riezky-gitH/SIMPAS-BOILER/Hardware/3D_Render/pcb_3d_preview.jpg

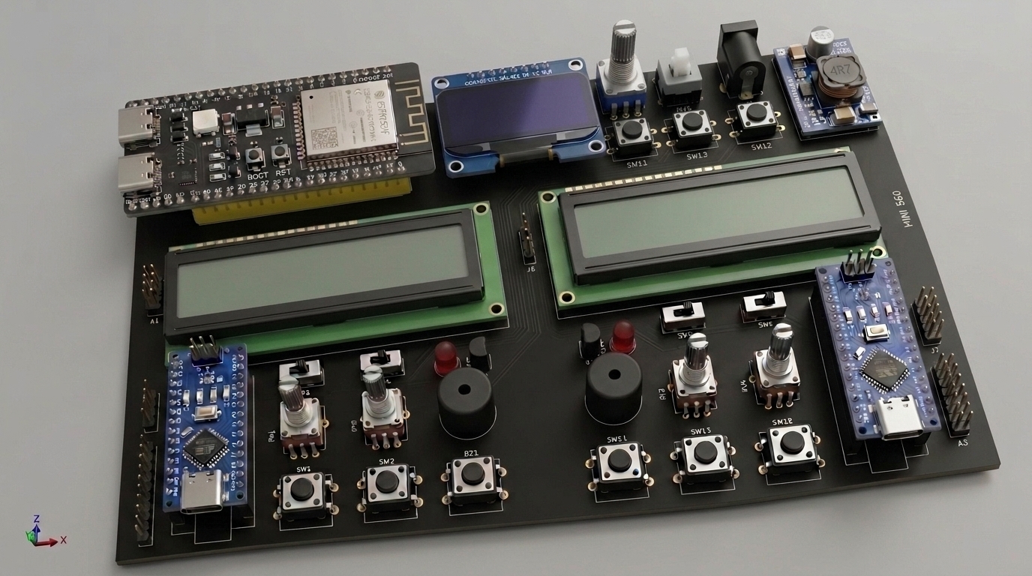
Hardware/3D_Render/pcb_3d_preview.jpg
