riezky-gitH/SIMPAS-BOILER/Hardware/Fabrication/cetak pcb wmlta zone area.pdf

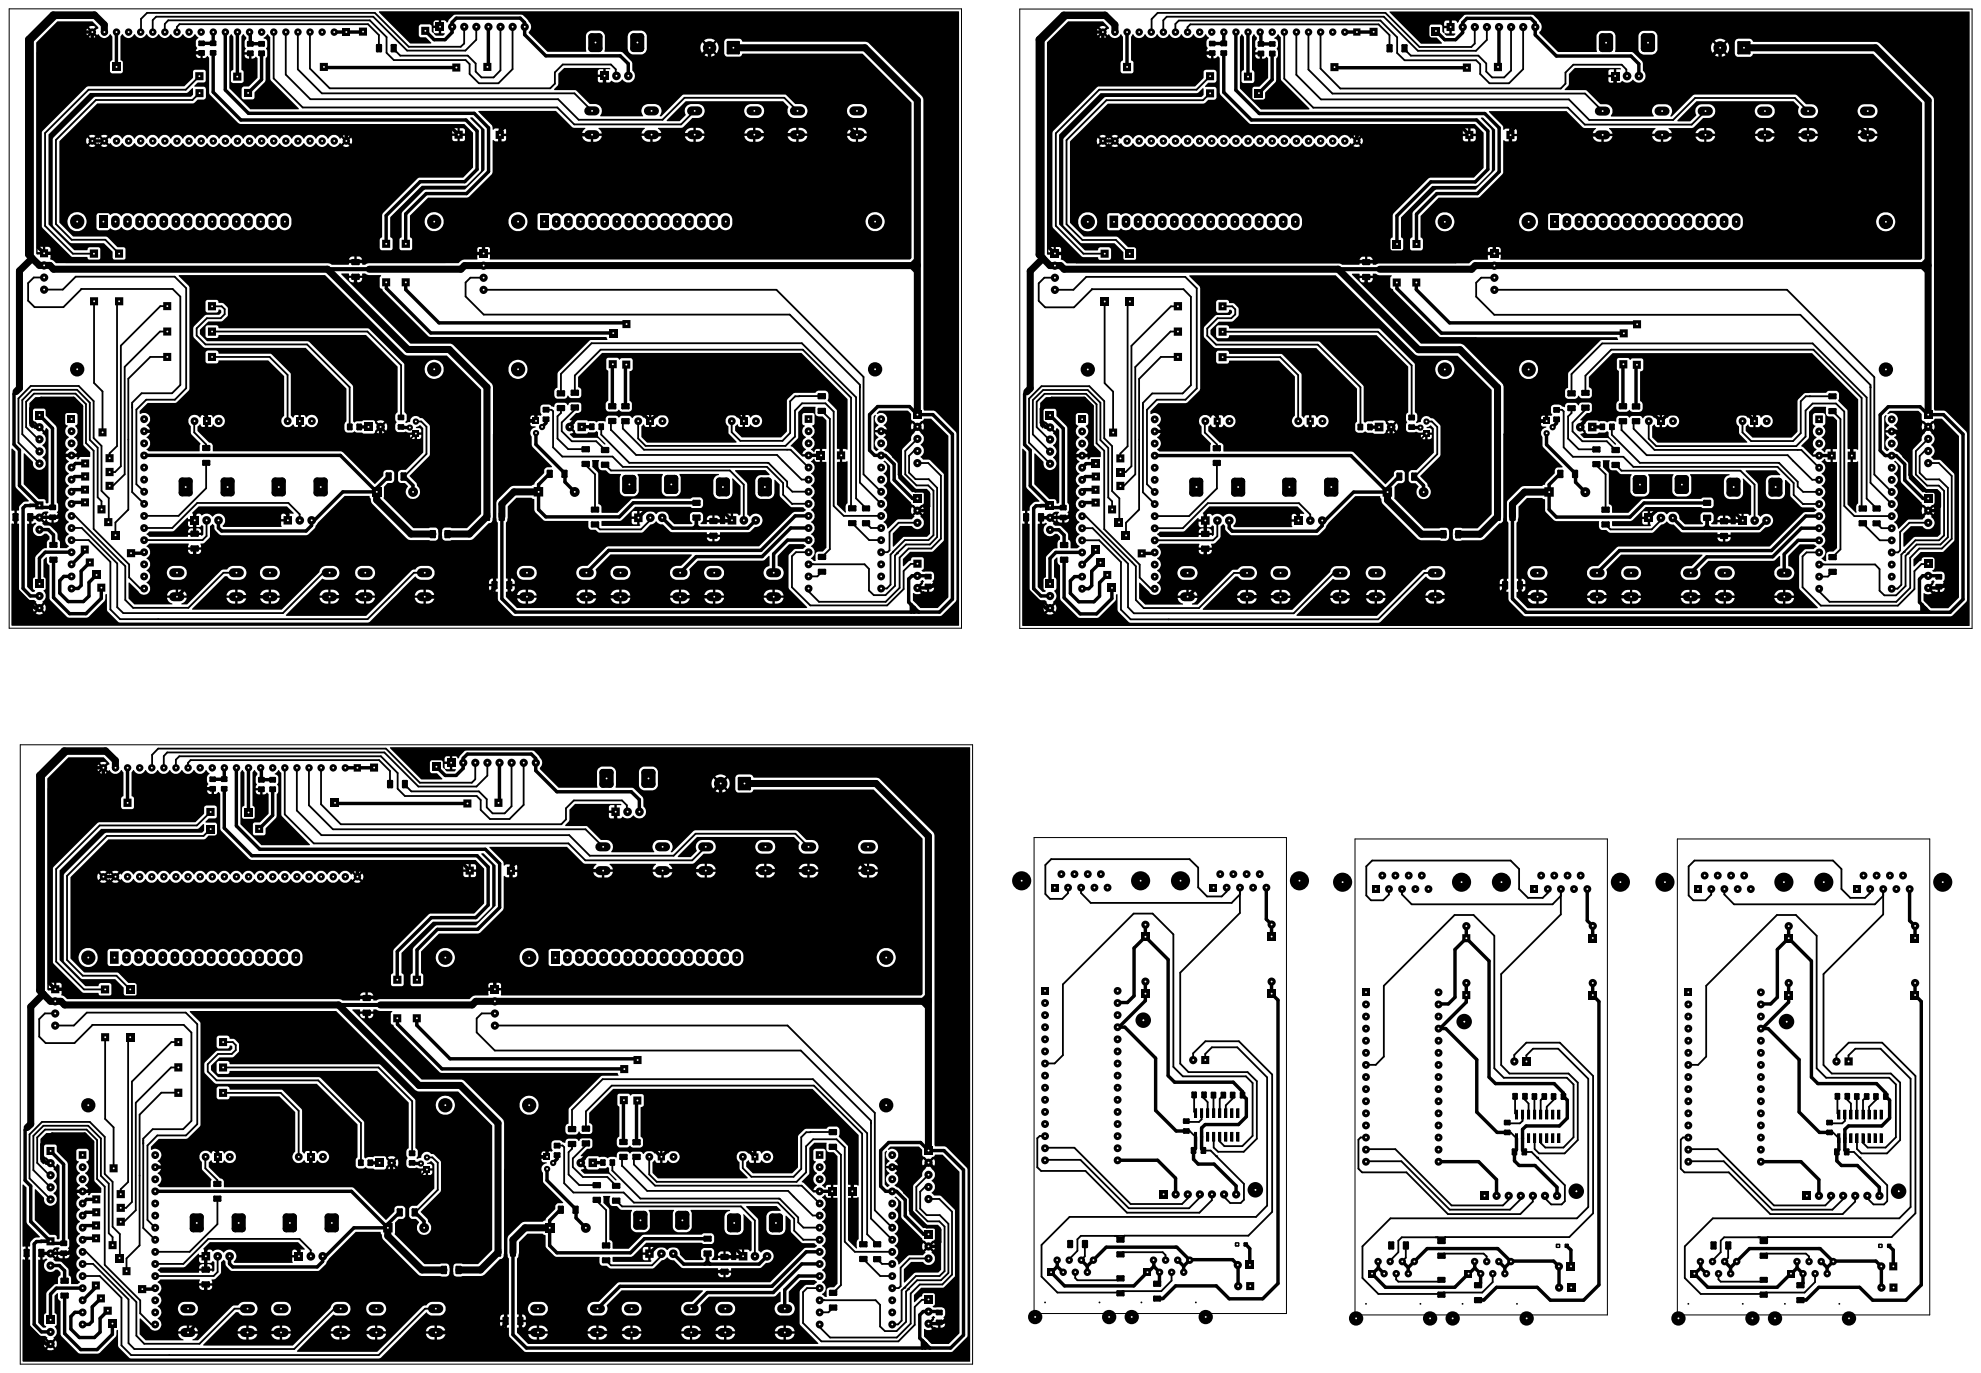
[picture p3: page 1]
