riezky-gitH/SIMPAS-BOILER/Hardware/Fabrication/esp32s3 wmlta-B_Cu.pdf

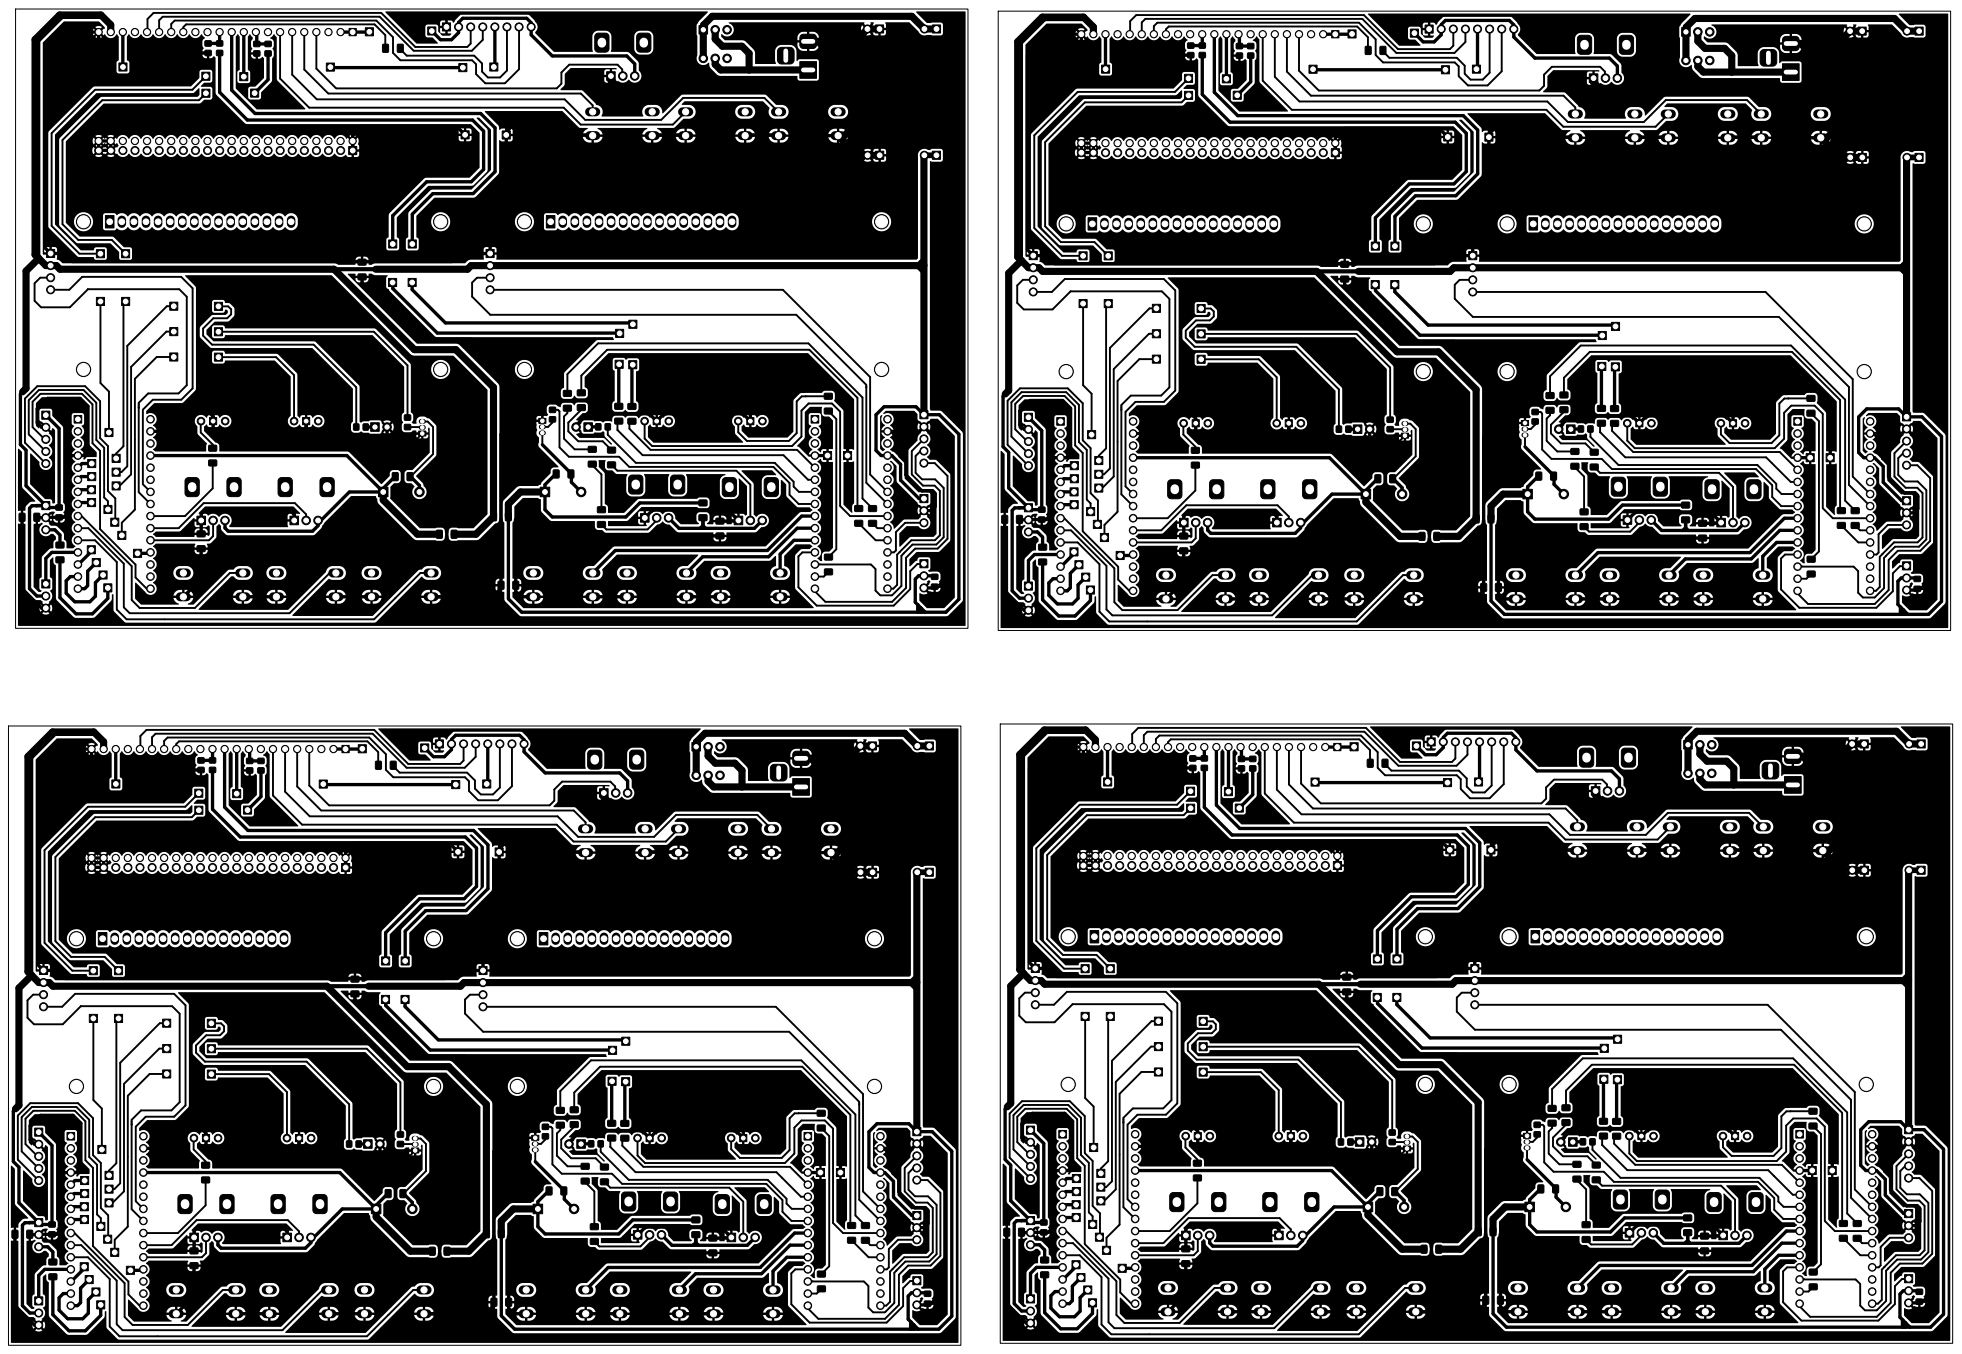
[picture p4: page 1]
