riezky-gitH/SIMPAS-BOILER/Hardware/PCB_KiCad/esp32s3 wmlta.kicad_sch

## KiCad design Hardware/PCB_KiCad/esp32s3 wmlta.kicad_sch (2026-10-23)

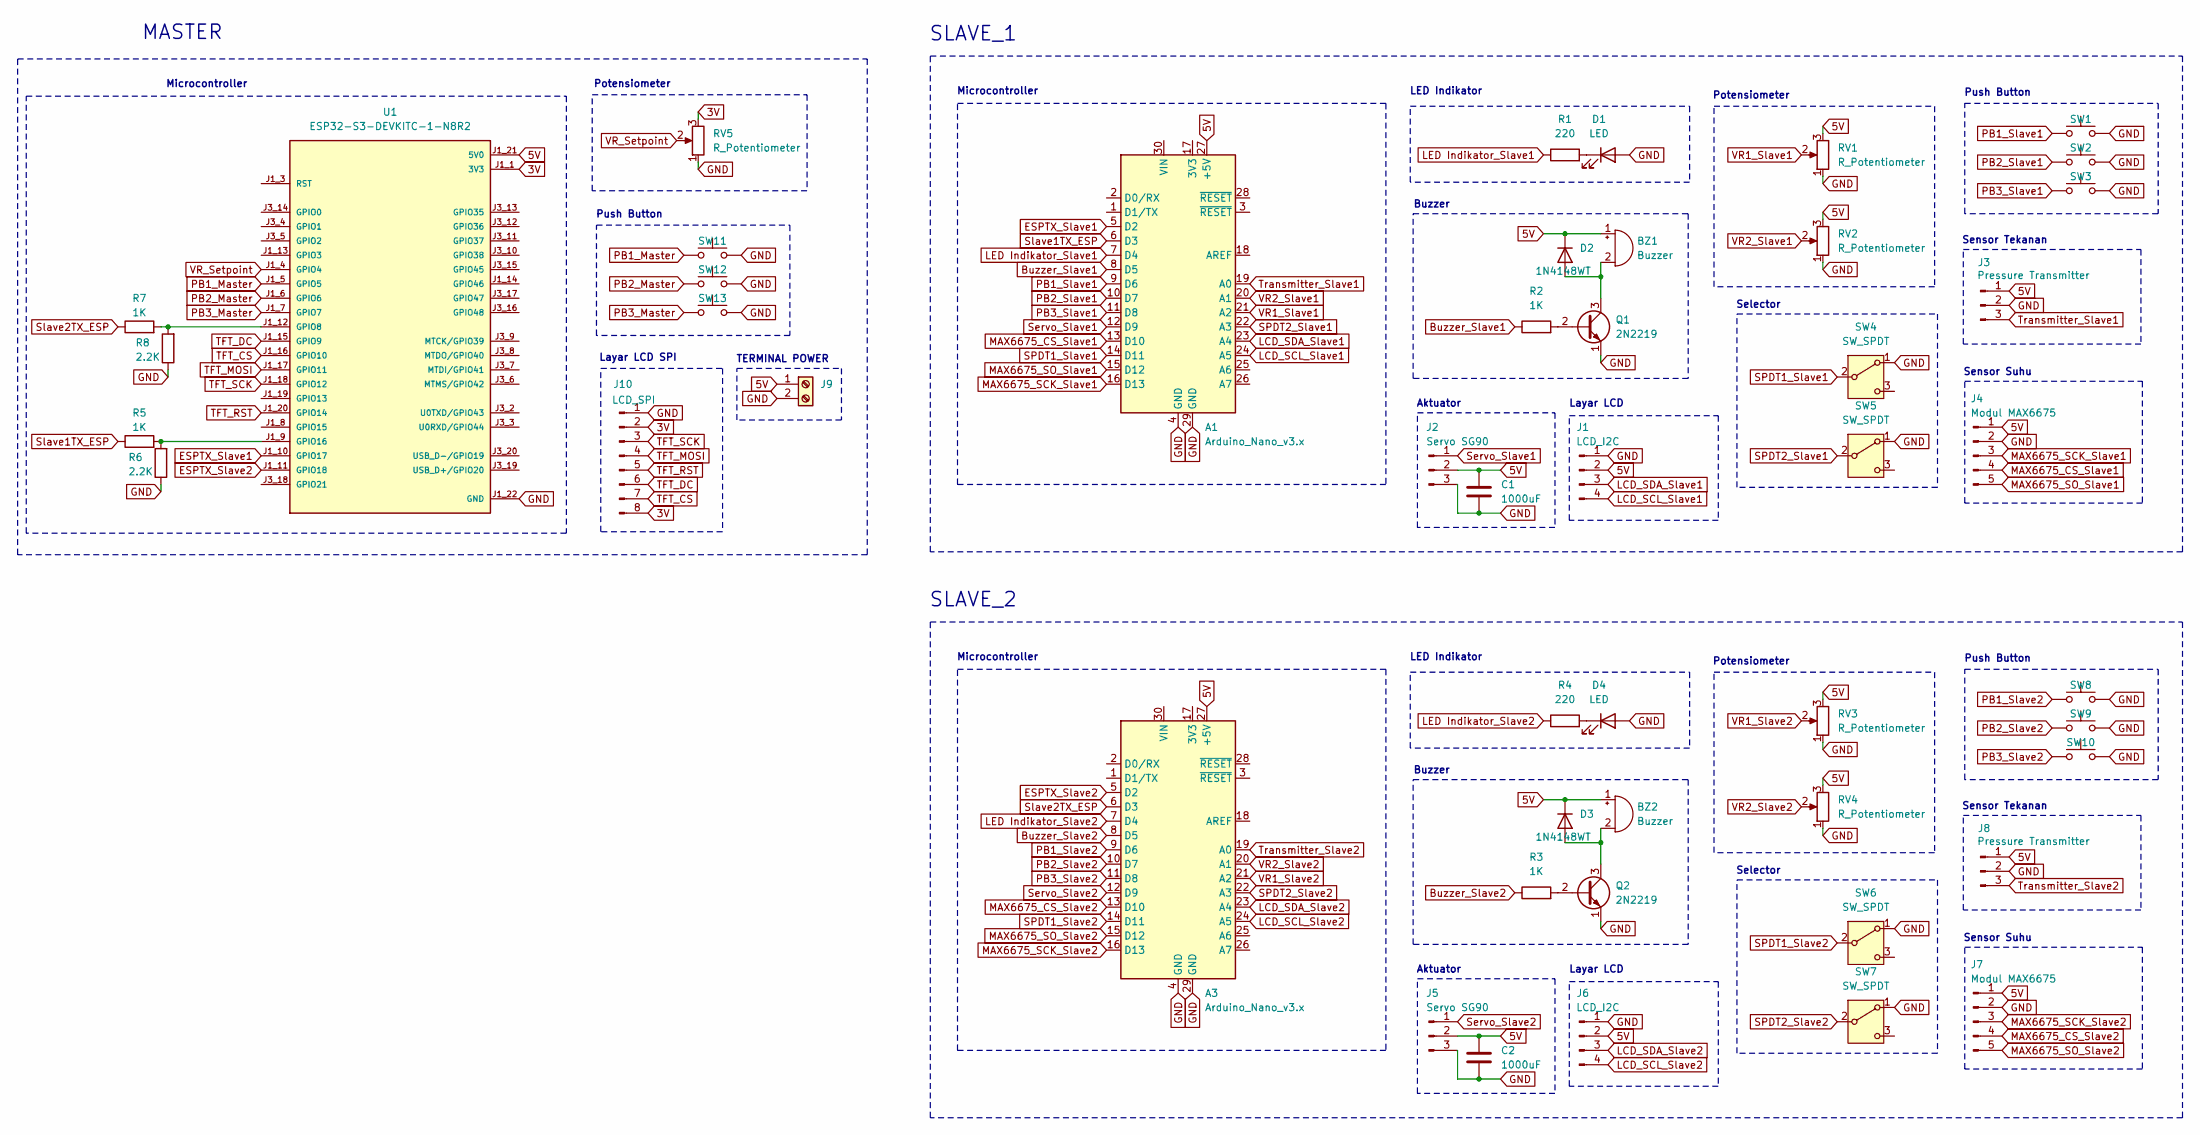
[picture p5: schematic esp32s3 wmlta.kicad_sch]

Parts:
A1, A3: Arduino_Nano_v3.x; Arduino_Nano
BZ1, BZ2: Buzzer; Buzzer_12x9.5RM7.6
C1, C2: 1000uF; C_0805_2012Metric_Pad1.18x1.45mm_HandSolder
D1, D4: LED; LED_D5.0mm
D2, D3: 1N4148WT; D_SOD-123
J1, J6: LCD_I2C; PinHeader_1x04_P2.54mm_Vertical
J2, J5: Servo SG90; PinHeader_1x03_P2.54mm_Vertical
J3, J8: Pressure Transmitter; PinHeader_1x03_P2.54mm_Vertical
J4, J7: Modul MAX6675; PinHeader_1x05_P2.54mm_Vertical
J9: Screw_Terminal_01x02; TerminalBlock_MaiXu_MX126-5.0-02P_1x02_P5.00mm
J10: LCD_SPI; PinHeader_1x08_P2.54mm_Vertical
Q1, Q2: 2N2219; TO-92
R1, R4: 220; R_0805_2012Metric_Pad1.20x1.40mm_HandSolder
R2, R3, R5, R7: 1K; R_0805_2012Metric_Pad1.20x1.40mm_HandSolder
R6, R8: 2.2K; R_0805_2012Metric_Pad1.20x1.40mm_HandSolder
RV1, RV2, RV3, RV4, RV5: R_Potentiometer; Potentiometer_Alps_RK09K_Single_Vertical
SW1, SW2, SW3, SW8, SW9, SW10, SW11, SW12, SW13: SW_Push; SW_PUSH-12mm
SW4, SW5, SW6, SW7: SW_SPDT; SW_Slide-03_Wuerth-WS-SLTV_10x2.5x6.4_P2.54mm
U1: ESP32-S3-DEVKITC-1-N8R2; XCVR_ESP32-S3-DEVKITC-1-N8R2; PARTREV V1

Connections:
3V: J10.2, J10.8, RV5.3, U1.J1_1 (3V3), U1.J1_2 (3V3)
5V: A1.27 (+5V), A3.27 (+5V), BZ1.1 (+), BZ2.1 (+), C1.1, C2.1, D2.1 (K), D3.1 (K), J1.2, J2.2, J3.1, J4.1, J5.2, J6.2, J7.1, J8.1, J9.1, RV1.3, RV2.3, RV3.3, RV4.3, U1.J1_21 (5V0)
Buzzer_Slave1: A1.8 (D5), R2.1
Buzzer_Slave2: A3.8 (D5), R3.1
ESPTX_Slave1: A1.5 (D2), U1.J1_10 (GPIO17)
ESPTX_Slave2: A3.5 (D2), U1.J1_11 (GPIO18)
GND: A1.4 (GND), A1.29 (GND), A3.4 (GND), A3.29 (GND), C1.2, C2.2, D1.2 (A), D4.2 (A), J1.1, J2.3, J3.2, J4.2, J5.3, J6.1, J7.2, J8.2, J9.2, J10.1, Q1.1 (E), Q2.1 (E), R6.1, R8.1, RV1.1, RV2.1, RV3.1, RV4.1, RV5.1, SW1.2, SW2.2, SW3.2, SW4.1 (A), SW5.1 (A), SW6.1 (A), SW7.1 (A), SW8.2, SW9.2, SW10.2, SW11.2, SW12.2, SW13.2, U1.J1_22 (GND), U1.J3_1 (GND), U1.J3_21 (GND), U1.J3_22 (GND)
LCD_SCL_Slave1: A1.24 (A5), J1.4
LCD_SCL_Slave2: A3.24 (A5), J6.4
LCD_SDA_Slave1: A1.23 (A4), J1.3
LCD_SDA_Slave2: A3.23 (A4), J6.3
LED Indikator_Slave1: A1.7 (D4), R1.1
LED Indikator_Slave2: A3.7 (D4), R4.1
MAX6675_CS_Slave1: A1.13 (D10), J4.4
MAX6675_CS_Slave2: A3.13 (D10), J7.4
MAX6675_SCK_Slave1: A1.16 (D13), J4.3
MAX6675_SCK_Slave2: A3.16 (D13), J7.3
MAX6675_SO_Slave1: A1.15 (D12), J4.5
MAX6675_SO_Slave2: A3.15 (D12), J7.5
unnamed: BZ1.2 (-), D2.2 (A), Q1.3 (C)
unnamed: BZ2.2 (-), D3.2 (A), Q2.3 (C)
unnamed: D1.1 (K), R1.2
unnamed: D4.1 (K), R4.2
unnamed: Q1.2 (B), R2.2
unnamed: Q2.2 (B), R3.2
unnamed: R5.2, R6.2, U1.J1_9 (GPIO16)
unnamed: R7.2, R8.2, U1.J1_12 (GPIO8)
PB1_Master: SW11.1, U1.J1_5 (GPIO5)
PB1_Slave1: A1.9 (D6), SW1.1
PB1_Slave2: A3.9 (D6), SW8.1
PB2_Master: SW12.1, U1.J1_6 (GPIO6)
PB2_Slave1: A1.10 (D7), SW2.1
PB2_Slave2: A3.10 (D7), SW9.1
PB3_Master: SW13.1, U1.J1_7 (GPIO7)
PB3_Slave1: A1.11 (D8), SW3.1
PB3_Slave2: A3.11 (D8), SW10.1
SPDT1_Slave1: A1.14 (D11), SW4.2 (B)
SPDT1_Slave2: A3.14 (D11), SW6.2 (B)
SPDT2_Slave1: A1.22 (A3), SW5.2 (B)
SPDT2_Slave2: A3.22 (A3), SW7.2 (B)
Servo_Slave1: A1.12 (D9), J2.1
Servo_Slave2: A3.12 (D9), J5.1
Slave1TX_ESP: A1.6 (D3), R5.1
Slave2TX_ESP: A3.6 (D3), R7.1
TFT_CS: J10.7, U1.J1_16 (GPIO10)
TFT_DC: J10.6, U1.J1_15 (GPIO9)
TFT_MOSI: J10.4, U1.J1_17 (GPIO11)
TFT_RST: J10.5, U1.J1_20 (GPIO14)
TFT_SCK: J10.3, U1.J1_18 (GPIO12)
Transmitter_Slave1: A1.19 (A0), J3.3
Transmitter_Slave2: A3.19 (A0), J8.3
VR1_Slave1: A1.21 (A2), RV1.2
VR1_Slave2: A3.21 (A2), RV3.2
VR2_Slave1: A1.20 (A1), RV2.2
VR2_Slave2: A3.20 (A1), RV4.2
VR_Setpoint: RV5.2, U1.J1_4 (GPIO4)

Notes on the sheet:
Push Button
Aktuator
Layar LCD
Potensiometer
Sensor Suhu
SLAVE_2
Microcontroller
LED Indikator
Buzzer
TERMINAL POWER
Selector
MASTER
Layar LCD SPI
SLAVE_1
Sensor Tekanan
