riezky-gitH/SIMPAS-BOILER/Firmware/Master_ESP32S3/GuideQr.h

// Generated from the supplied QR; module-exact, no image resampling.
#pragma once
#include <Arduino.h>
constexpr int GUIDE_QR_SIZE=33;
constexpr const char* GUIDE_URL="https://github.com/riezky-gitH/SIMPAS-BOILER";
const uint8_t GUIDE_QR[] PROGMEM={
0xFE,0xBD,0xF9,0x3F,0x80,0x82,0x94,0x27,0xA0,0x80,0xBA,0x78,0x56,0xAE,0x80,0xBA,
0xAB,0x9E,0xAE,0x80,0xBA,0x1E,0x49,0x2E,0x80,0x82,0x2C,0x3E,0x20,0x80,0xFE,0xAA,
0xAA,0xBF,0x80,0x00,0xBA,0x68,0x00,0x00,0xB7,0x28,0x76,0xA5,0x80,0x50,0xE0,0x9D,
0x36,0x00,0x97,0xDA,0xC9,0x3D,0x80,0xE8,0xF6,0xA0,0x74,0x00,0x9A,0xA8,0x25,0x54,
0x80,0x95,0x8C,0xA7,0xB3,0x00,0xEF,0x27,0xC4,0xBC,0x00,0xB1,0x86,0xBC,0x6E,0x00,
0xC3,0x29,0x37,0x68,0x00,0xDD,0xA7,0x4F,0xED,0x00,0x12,0x49,0xCA,0xFB,0x00,0xF9,
0x67,0x95,0xC9,0x00,0x52,0x08,0x28,0x07,0x00,0xA5,0x79,0x64,0x12,0x80,0x12,0x34,
0x85,0x7D,0x80,0x58,0xD8,0xB0,0xAD,0x00,0x8B,0x47,0x43,0xFB,0x80,0x00,0xCD,0xF8,
0x8D,0x80,0xFE,0xE8,0x1B,0xA8,0x00,0x82,0xE1,0x8F,0x8F,0x80,0xBA,0x65,0x59,0xFB,
0x00,0xBA,0xA4,0x7D,0x11,0x80,0xBA,0xE8,0x32,0x36,0x00,0x82,0x7F,0xF3,0x18,0x80,
0xFE,0xB5,0xC5,0x0C,0x00
};
