riezky-gitH/SIMPAS-BOILER/Firmware/Master_ESP32S3/Secrets.example.h

#pragma once
constexpr const char* STA_SSID="";
constexpr const char* STA_PASSWORD="";
constexpr const char* MQTT_HOST=""; // Optional private LAN broker; empty disables MQTT.
constexpr const char* MQTT_USER="";
constexpr const char* MQTT_PASSWORD="";
constexpr uint16_t MQTT_PORT=1883;
