riezky-gitH/SIMPAS-BOILER/(commit log)

2026-10-23 Initial commit: SIMPAS-BOILER (Sistem Monitoring & Proteksi Automatis Solenoid Boiler)
2026-10-23 feat(hardware): add KiCad PCB schematics, layout, fabrication PDFs, and 3D render
    [esp32s3 wmlta.kicad_pcb, esp32s3 wmlta.kicad_sch]
2026-10-27 feat: publish current SIMPAS v3 firmware and refresh project documentation
    [partitions.csv]
